F3ZE/Space_Hexapod/5.Docs/微信图片_2025-06-11_200251_431.jpg

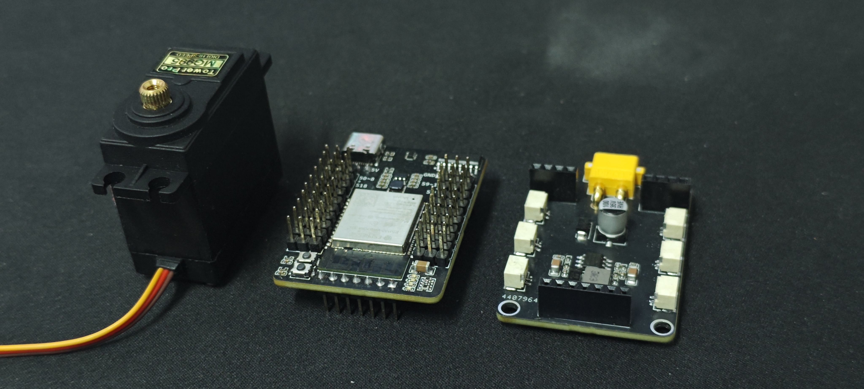
5.Docs/微信图片_2025-06-11_200251_431.jpg
