F3ZE/Space_Hexapod/1.Hardware/Space_Hexapod_hw_v1/BOM_Board1_SpaceHexapod_2025-04-03.xlsx

No. | Quantity | Comment | Designator | Footprint | Value | Manufacturer Part | Manufacturer | Supplier Part | Supplier
1 | 4 | NCD0402G1 | 3V3,BOOT,RXD,TXD | LED0402-RD |  | NCD0402G1 | 国星光电 | C130723 | LCSC
2 | 2 | TS-1088-AR02016 | BOOT1,EN | SW-SMD_L3.9-W3.0-P4.45 |  | TS-1088-AR02016 | XUNPU(讯普) | C720477 | LCSC
3 | 1 | 100pF | C1 | C0402 | 100pF | GRM1555C1H101JA01D | muRata(村田) | C77177 | LCSC
4 | 4 | 10uF | C2,C7,C9,C12 | C0402 | 10uF | CL05A106MQ5NUNC | SAMSUNG(三星) | C15525 | LCSC
5 | 2 | 100n | C3,C4 | C0402 | 100n | CL05B104KB54PNC | SAMSUNG(三星) |  | LCSC
6 | 2 | 10uF | C5,C6 | C1206 | 10uF | HGC1206R5106K500NSPJ | Chinocera(华瓷) | C7432781 | LCSC
7 | 4 | 100nF | C8,C10,C33,C36 | C0402 | 100nF | CC0402KRX7R7BB104 | YAGEO(国巨) | C60474 | LCSC
8 | 20 | 100nF | C11,C15,C16,C17,C18,C19,C20,C21,C22,C23,C26,C27,C28,C29,C30,C31,C34,C35,C37,C38 | C0402 | 100nF | CL05B104KB54PNC | SAMSUNG(三星) | C307331 | LCSC
9 | 1 | 100uF | C13 | CAP-SMD_BD6.3-L6.6-W6.6-LS7.6-FD-1 | 100uF | RVE100UF35V67RV0072 | KNSCHA(科尼盛) | C2836437 | LCSC
10 | 1 | 1uF | C14 | C0402 | 1uF | GRM155R61H105KE05D | muRata(村田) | C1518208 | LCSC
11 | 1 | 2.2nF | C24 | C0402 | 2.2nF | CC0402KRX7R9BB222 | YAGEO(国巨) | C106861 | LCSC
12 | 1 | 10nF | C25 | C0402 | 10nF | CL05B103KB5NNNC | SAMSUNG(三星) | C15195 | LCSC
13 | 1 | 100uF | C32 | C1206 | 100uF | CL31A107MQHNNNE | SAMSUNG(三星) | C15008 | LCSC
14 | 1 | XT30PW-M | CN1 | CONN-TH_XT30PW-M |  | XT30PW-M | AMASS(艾迈斯) | C431092 | LCSC
15 | 8 | ZX-XH2.54-2PWT | CN2,CN3,CN4,CN5,CN6,CN7,CN8,CN9 | CONN-SMD_2P-P2.54_MEGASTAR_ZX-XH2.54-2PWT |  | ZX-XH2.54-2PWT | Megastar(兆星) | C7429671 | LCSC
16 | 1 | SS34 | D1 | SMA_L4.2-W2.7-LS5.0-RD |  | SS34 | KUU | C2891718 | LCSC
17 | 9 | SMAJ26A | D2,D3,D4,D7,D8,D11,D12,D15,D16 | SMA_L4.3-W2.6-LS5.1-RD |  | SMAJ26A | GOODWORK(固得沃克) | C2848697 | LCSC
18 | 8 | BZT52C10S | D5,D6,D9,D10,D13,D14,D17,D18 | SOD-323_L1.6-W1.3-LS2.7-RD |  | BZT52C10S | 晶导微电子 | C353563 | LCSC
19 | 18 | PZ254V-11-03P | H1,H2,H3,H4,H5,H6,H7,H8,H9,H10,H11,H12,H13,H14,H15,H16,H17,H18 | HDR-TH_3P-P2.54-V-M |  | PZ254V-11-03P | XFCN(兴飞) | C2937625 | LCSC
20 | 1 | 4.7uH | L1 | IND-SMD_L5.9-W5.2 | 4.7uH | MAPM0530F-4R7M-LF | microgate(麦捷科技) | C696442 | LCSC
21 | 1 | UMH3N | Q1 | SC-70-6_L2.2-W1.3-P0.65-LS2.1-BR |  | UMH3N | CJ(江苏长电/长晶) | C62892 | LCSC
22 | 8 | HYG110P04LQ2C2 | Q2,Q3,Q6,Q7,Q10,Q11,Q14,Q15 | PDFN-8_L5.2-W5.9-P1.27-LS6.2-BL |  | HYG110P04LQ2C2 | HUAYI(华羿微) | C2891580 | LCSC
23 | 8 | MMBT3904T | Q4,Q5,Q8,Q9,Q12,Q13,Q16,Q17 | SOT-523-3_L1.6-W0.8-P1.00-LS1.6-BR |  | MMBT3904T | CJ(江苏长电/长晶) | C61616 | LCSC
24 | 1 | 100k | R1 | R0402 | 100k | 0402WGF1003TCE | UNI-ROYAL(厚声) |  | LCSC
25 | 26 | 10kΩ | R2,R8,R14,R15,R16,R17,R18,R19,R22,R23,R24,R25,R26,R27,R30,R31,R32,R33,R34,R35,R41,R42,R43,R44,R45,R46 | R0402 | 10kΩ | 0402WGF1002TCE | UNI-ROYAL(厚声) | C25744 | LCSC
26 | 1 | 8.2k | R3 | R0402 | 8.2k | 0402WGF8201TCE | UNI-ROYAL(厚声) |  | LCSC
27 | 3 | 100kΩ | R4,R5,R6 | R0402 | 100kΩ | 0402WGF1003TCE | UNI-ROYAL(厚声) | C25741 | LCSC
28 | 1 | 44.2kΩ | R7 | R0402 | 44.2kΩ | FRC0402F4422TS | FOJAN(富捷) | C2933098 | LCSC
29 | 1 | 0Ω | R9 | R0402 | 0Ω | 0402WGF0000TCE | UNI-ROYAL(厚声) | C17168 | LCSC
30 | 2 | 5kΩ | R10,R11 | R0402 | 5kΩ | RC0402FR-075KL | YAGEO(国巨) | C477765 | LCSC
31 | 11 | 1kΩ | R12,R13,R20,R21,R28,R29,R36,R37,R38,R39,R40 | R0402 | 1kΩ | RT0402BRD071KL | YAGEO(国巨) | C852624 | LCSC
32 | 2 | 1kΩ | RN1,RN2 | RES-ARRAY-SMD_0603-8P-L3.2-W1.6-BL | 1kΩ | RC-ML08W102JT | FH(风华) | C160614 | LCSC
33 | 1 | K3-1391D-5MM | SW1 | SW-TH_K3-1391D-5MM |  | K3-1391D-5MM | 韩国韩荣 | C970579 | LCSC
34 | 2 | PCA9685PW,118 | U1,U4 | TSSOP-28_L9.7-W4.4-P0.65-LS6.4-TL |  | PCA9685PW,118 | NXP(恩智浦) | C2678753 | LCSC
35 | 1 | MP1584EN-LF-P | U2 | SOIC-8_L4.9-W3.9-P1.27-LS6.0-TL-EP-1 |  | MP1584EN-LF-P | MPS(芯源) | C7304223 | LCSC
36 | 1 | AMS1117-3.3 | U3 | SOT-223-3_L6.5-W3.4-P2.30-LS7.0-BR |  | AMS1117-3.3 | AMS | C6186 | LCSC
37 | 1 | CH340C | U5 | SOP-16_L10.0-W3.9-P1.27-LS6.0-BL |  | CH340C | WCH(南京沁恒) | C84681 | LCSC
38 | 1 | ESP32-WROOM-32E-N8 | U6 | WIFI-SMD_ESP32-WROOM-32E |  | ESP32-WROOM-32E-N8 | ESPRESSIF(乐鑫) | C701342 | LCSC
39 | 1 | MPU-6050 | U7 | QFN-24_L4.0-W4.0-P0.50-BL-EP2.7 |  | MPU-6050 | TDK InvenSense(应美盛) | C24112 | LCSC
40 | 1 | TYPE-C16PIN | USB1 | USB-C-SMD_TYPE-C16PIN |  | TYPE-C16PIN | SHOU HAN(首韩) | C393939 | LCSC
