F3ZE/Space_Hexapod/2.Firmware/SpaceHexapod_fw_v1/build/bootloader-prefix/src/bootloader-stamp/bootloader-source_dirinfo.txt

# This is a generated file and its contents are an internal implementation detail.
# The download step will be re-executed if anything in this file changes.
# No other meaning or use of this file is supported.

method=source_dir
command=
source_dir=G:/Espressif/frameworks/esp-idf-v5.4.1/components/bootloader/subproject
work_dir=
