F3ZE/Space_Hexapod/1.Hardware/Space_Hexapod_hw_v2/debug_log.md

## 20250610

8.2k dcdc采样电阻封装买错成了0608，应该是0402

## 20250611

Q:

1.MG995单舵机测试，反复切换的时候TLV62568DBVR会烧，直接击穿

1.1滤波电容耐压不够，容值不够？

2.电磁铁无法控制

3.电磁铁发热

4.板子设计问题

5.学习各类二极管（稳压、齐纳。。。）

S:

1.TLV62568DBVR输入电压上限5.5V，输入纹波太大，更换DCDC TPS62056DGSR

1.2.MP1584EN串联 24V-12V-5V

4.电感下面不要铺铜

4.2大封装mosvout直接铺铜

4.3usb要走差分线

4.4用放大器测电池电压

4.5用多层板，首层（第二层信号），第三层地，第四层VCC，铺铜部分区域太细了

## 20250612

S:

采样电阻精度提高，滤波电容耐压加大
