F3ZE/Space_Hexapod/1.Hardware/Space_Hexapod_hw_v2/SCH_Schematic1_2025-05-06.pdf

POWER | CONNECTOR

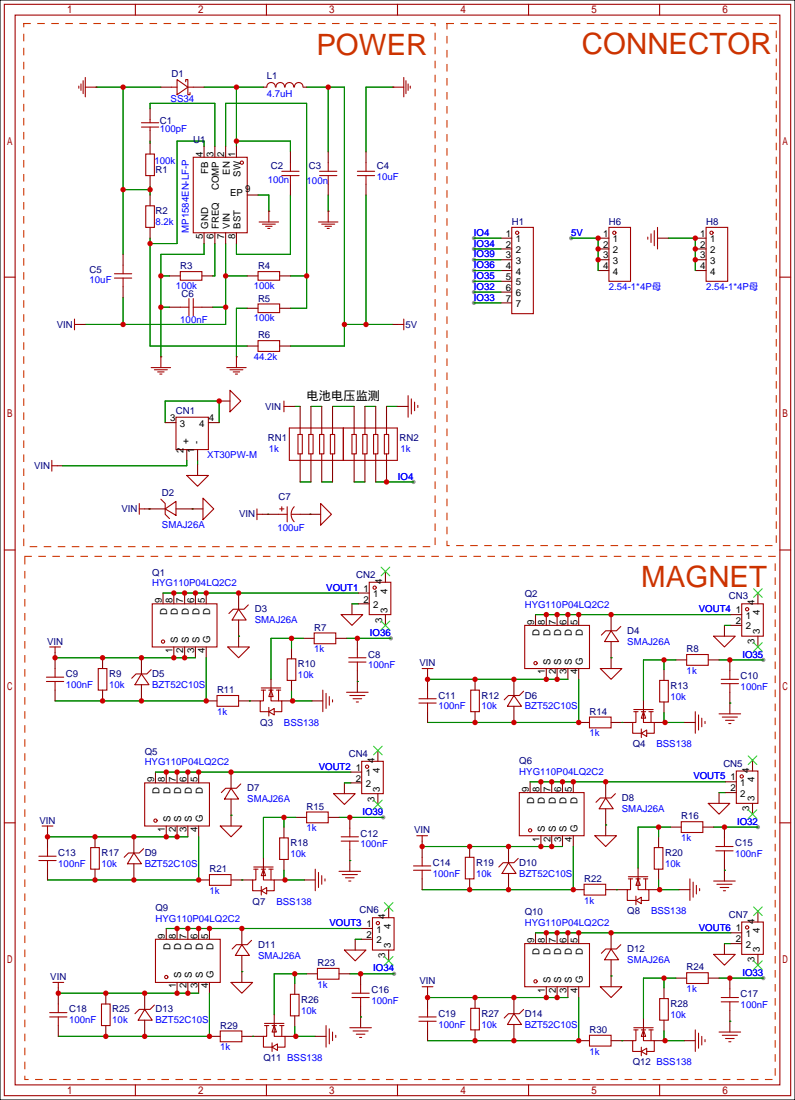
[picture p3: page 1]
