F3ZE/Space_Hexapod/1.Hardware/Space_Hexapod_hw_v2/SCH_SpaceHexapod_V2_2025-05-06.pdf

# PWM

# DSR# 10 RI# 11 DCD# 12 DTR# 13 RTS# 14 R232 15 VCC 16

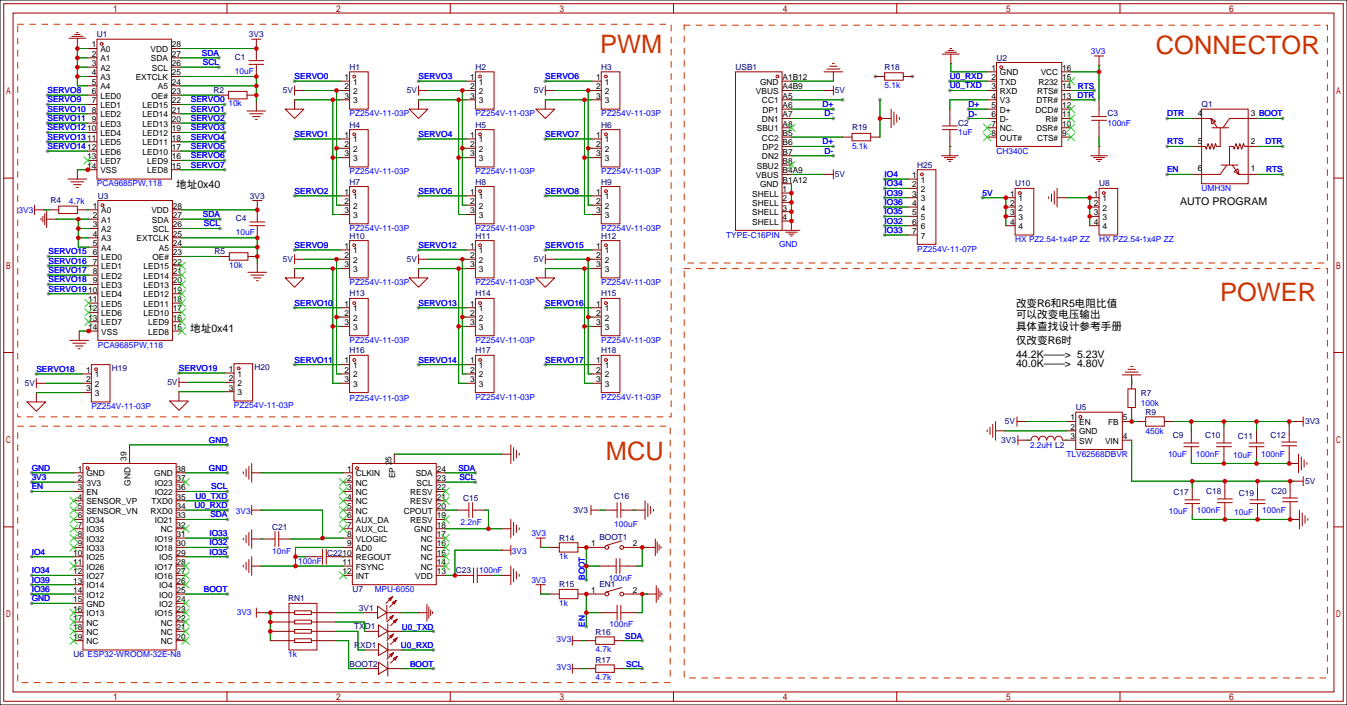
[picture p4: page 1]
