F3ZE/Space_Hexapod/(list of files, drawings)

Other design files:
1.Hardware/Space_Hexapod_hw_v1/Space_Hexapod_hw_v1.eprj
1.Hardware/Space_Hexapod_hw_v2/Space_Hexapod.eprj
1.Hardware/Space_Hexapod_V2.1.eprj
