F3ZE/Space_Hexapod/2.Firmware/SpaceHexapod_Arduino32/Stepdata.h

//三角步态前进
float forward[40][18] = {
16.11, -30, -30, -12.33, -30, -30, -16.3, -30, -30, 16.11, -30, -30, -12.33, -30, -30, -16.3, -30, -30,
15.94, -31.5, -31.5, -12.21, -30, -30, -16.1, -31.5, -31.5, 15.94, -30, -30, -12.21, -31.5, -31.5, -16.1, -30, -30,
15.49, -33, -33, -11.9, -30, -30, -15.56, -33, -33, 15.49, -30, -30, -11.9, -33, -33, -15.56, -30, -30,
14.64, -34.5, -34.5, -11.31, -30, -30, -14.59, -34.5, -34.5, 14.64, -30, -30, -11.31, -34.5, -34.5, -14.59, -30, -30,
13.32, -36, -36, -10.39, -30, -30, -13.09, -36, -36, 13.32, -30, -30, -10.39, -36, -36, -13.09, -30, -30,
11.49, -37.5, -37.5, -9.08, -30, -30, -11.09, -37.5, -37.5, 11.49, -30, -30, -9.08, -37.5, -37.5, -11.09, -30, -30,
9.16, -39, -39, -7.37, -30, -30, -8.64, -39, -39, 9.16, -30, -30, -7.37, -39, -39, -8.64, -30, -30,
6.39, -40.5, -40.5, -5.25, -30, -30, -5.87, -40.5, -40.5, 6.39, -30, -30, -5.25, -40.5, -40.5, -5.87, -30, -30,
3.29, -42, -42, -2.77, -30, -30, -2.93, -42, -42, 3.29, -30, -30, -2.77, -42, -42, -2.93, -30, -30,
0, -43.5, -43.5, 0, -30, -30, 0, -43.5, -43.5, 0, -30, -30, 0, -43.5, -43.5, 0, -30, -30,
-3.29, -42, -42, 2.93, -30, -30, 2.77, -42, -42, -3.29, -30, -30, 2.93, -42, -42, 2.77, -30, -30,
-6.39, -40.5, -40.5, 5.87, -30, -30, 5.25, -40.5, -40.5, -6.39, -30, -30, 5.87, -40.5, -40.5, 5.25, -30, -30,
-9.16, -39, -39, 8.64, -30, -30, 7.37, -39, -39, -9.16, -30, -30, 8.64, -39, -39, 7.37, -30, -30,
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
0.00,-28.29,-36.37,2.08,-29.87,-27.64,-8.26,-27.53,-16.30,-0.00,-28.30,-36.37,-16.31,-26.95,-37.80,2.39,-29.87,-32.10,
0.00,-28.30,-36.37,2.08,-29.87,-27.64,-8.27,-26.80,-15.69,-0.00,-28.30,-36.37,-16.32,-26.94,-37.80,2.39,-29.87,-32.10,
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
};
