F3ZE/Space_Hexapod/(commit log)

2025-06-11 [model]model init
    [BOM_Board1_SpaceHexapod_2025-04-03.xlsx, Space_Hexapod.eprj]
2025-06-12 [hw]v1 update
    [Space_Hexapod.eprj, Space_Hexapod_hw_v1.eprj]
2025-06-14 [model]model init“
2025-06-15 [commit]build(cmake): 更新 idf_as_lib 示例的构建和运行脚本
    - 为多个目标平台添加通用构建脚本
    - 实现从脚本名称自动推断目标平台
    - 更新运行脚本以适配新构建流程
    -统一构建和运行脚本格式
2025-06-15 [doc]chore: 更新 .gitignore 文件
    - 添加多个新文件和目录到忽略列表，包括临时文件、缓存文件、构建产物等- 新增对特定编辑器和开发工具（如 VS Code、Clion）的配置文件忽略
    - 忽略单元测试和覆盖率报告相关文件
    - 维持对 SolidWorks 文件的例外规则
2025-06-15 [doc]chore: 更新 .gitignore 文件
    - 添加 IDE 设置文件和构建目录到忽略列表
    - 移除冗余的 VS Code 和 Sublime Text 文件忽略规则
    - 删除 ESP-IDF 默认构建目录名的忽略规则
    - 简化 DWG 文件的忽略规则
2025-06-15 [doc]chore: 添加 .gitignore 文件以忽略特定文件和目录
    - 创建 .gitignore 文件，列出不希望 Git 跟踪的文件和目录模式
    - 包含多种开发工具和环境的忽略规则，如 Visual Studio Code、PyCharm、Eclipse 等- 忽略构建输出、临时文件、日志文件等
    - 保留某些特定文件类型，如 SolidWorks 文件
2025-06-16 refactor(main): 重构步态控制和舵机初始化逻辑
    - 调整髋关节摆动比例 Hs0 从 70 修改为 35
    - 新增基础角度数组 base_angles 和方向数组 k，用于更精确的舵机控制
    - 优化 applyServoAngles 函数，使用预设的基础角度和方向进行计算- 重构 initStandingPose 函数，简化为将所有舵机设置为 90 度
    - 移除不必要的 set_all_servos_angle 函数
    - 调整 PCA9685 初始化后的舵机设置逻辑
